StuartsProjects/HAB2/Pictures/Tracker HAB2 Parts.jpg

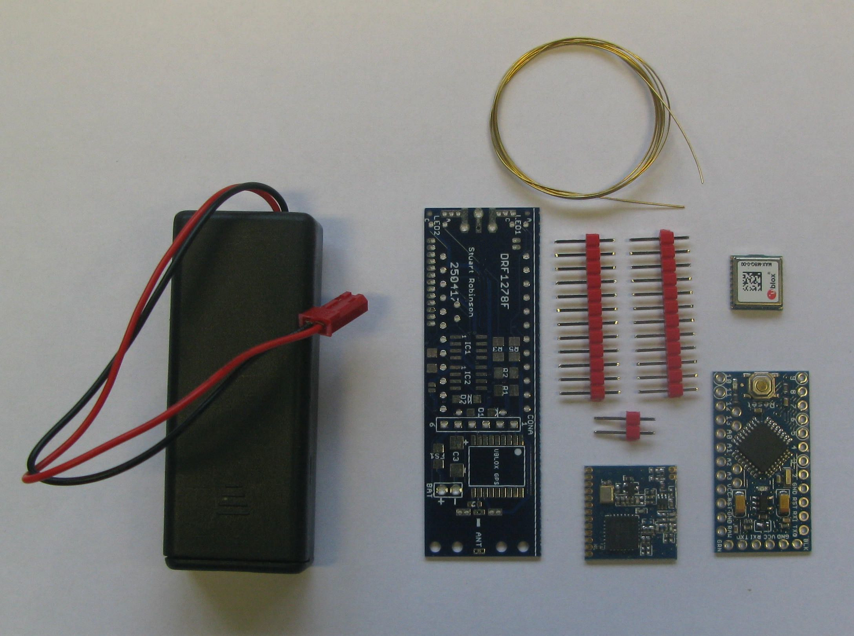
Pictures/Tracker HAB2 Parts.jpg
