StuartsProjects/HAB2/Pictures/Normal Pips.jpg

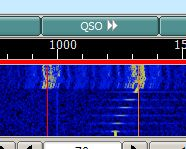
Pictures/Normal Pips.jpg
