StuartsProjects/HAB2/Board/GPS Breakout 200917 PCB.pdf

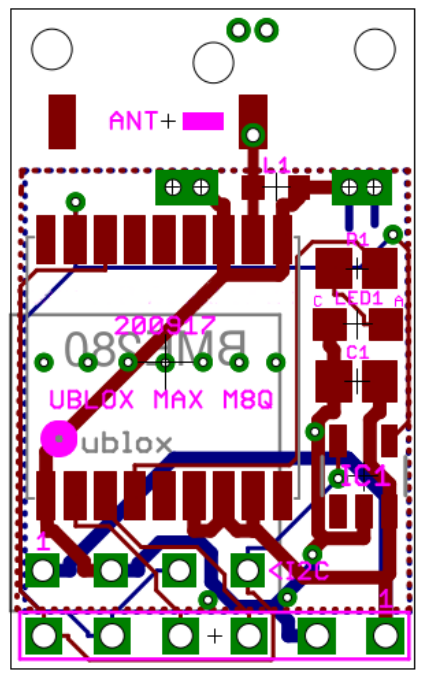
[picture p3: page 1]
