StuartsProjects/HAB2/Board/HAB2 Tracker RFM9x PCB 090218.pdf

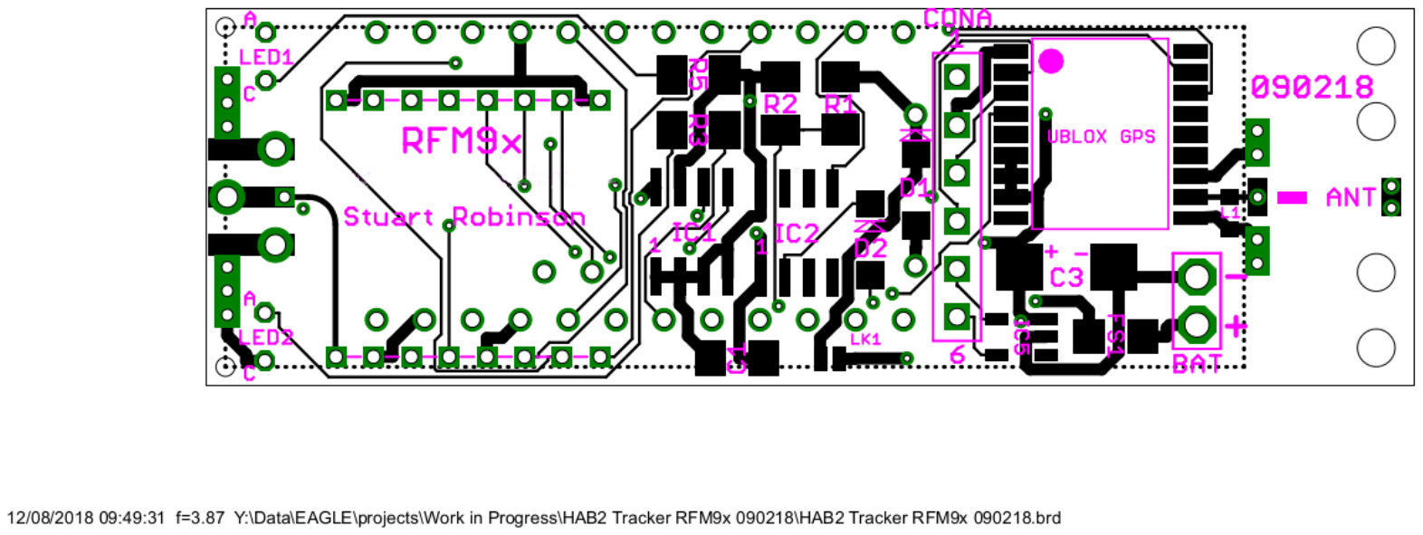
[picture p4: page 1]
