StuartsProjects/HAB2/Pictures/Breakout and BMP280.JPG

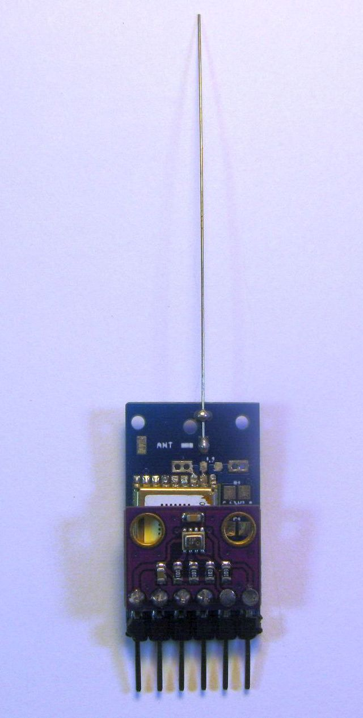
Pictures/Breakout and BMP280.JPG
