StuartsProjects/HAB2/Pictures/Breakout and TC74.JPG

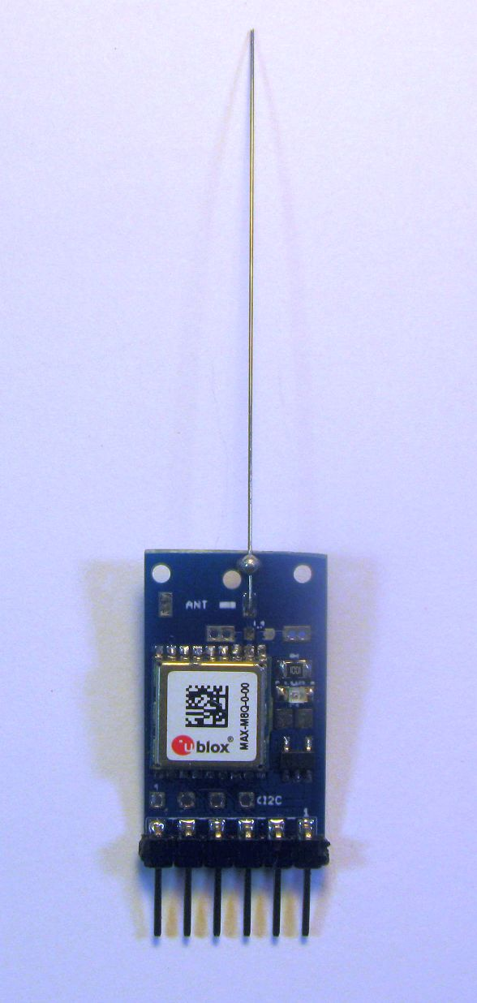
Pictures/Breakout and TC74.JPG
