StuartsProjects/HAB2/Pictures/GPS Breakout 200917.jpg

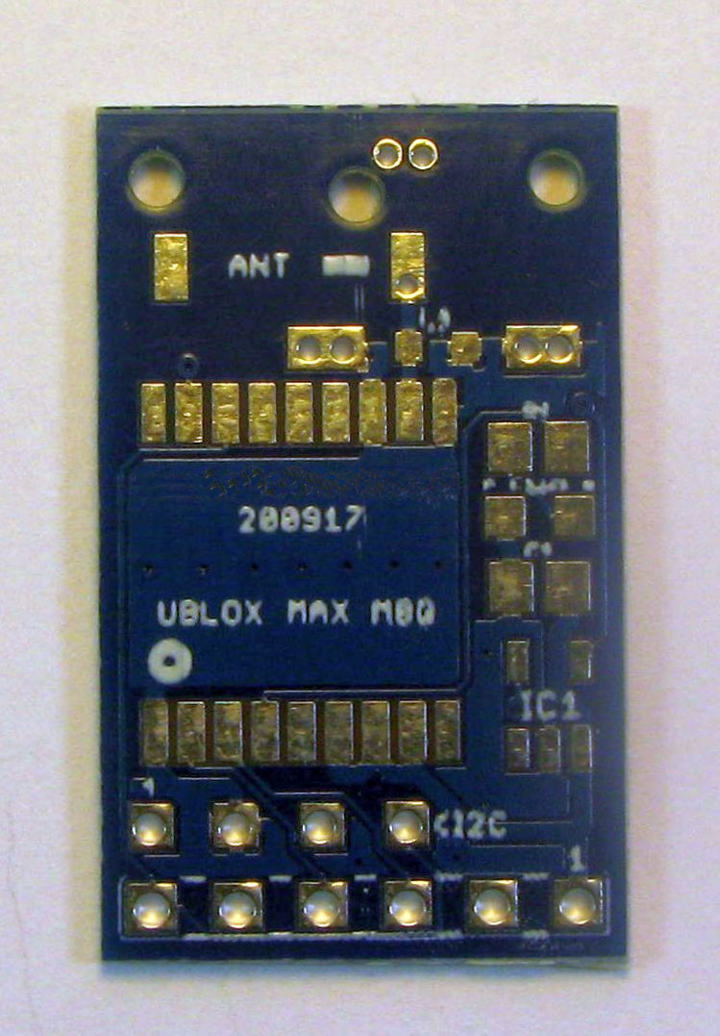
Pictures/GPS Breakout 200917.jpg
