StuartsProjects/HAB2/Pictures/HAB2 PCB.jpg

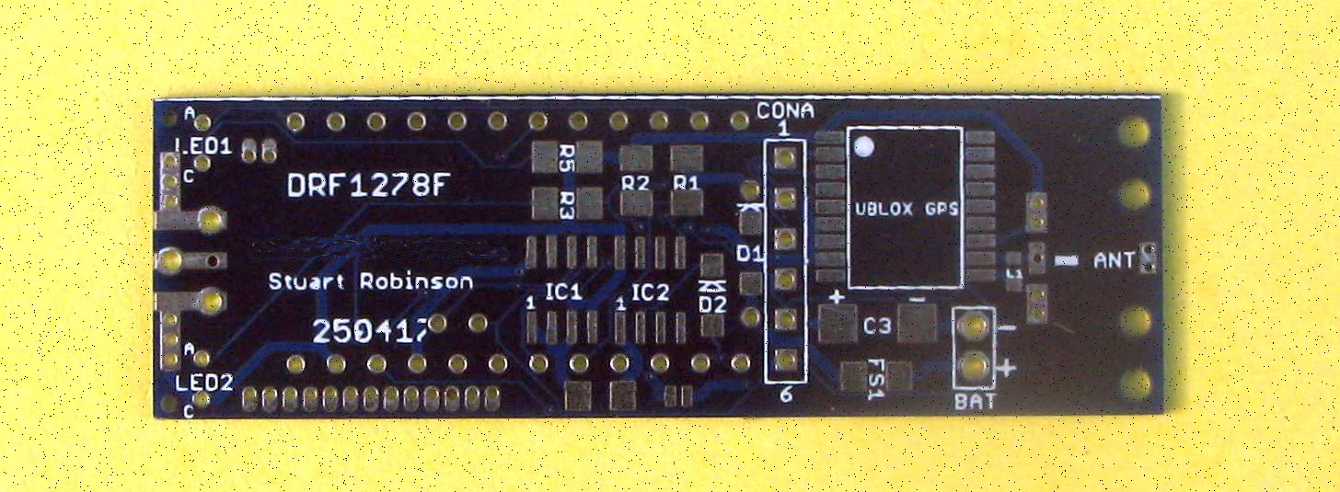
Pictures/HAB2 PCB.jpg
