StuartsProjects/HAB2/Pictures/IMG_1916.JPG

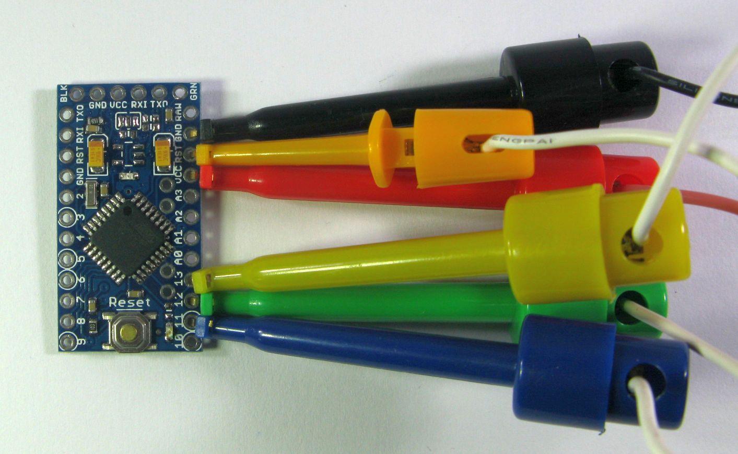
Pictures/IMG_1916.JPG
