StuartsProjects/HAB2/Pictures/IMG_1920.JPG

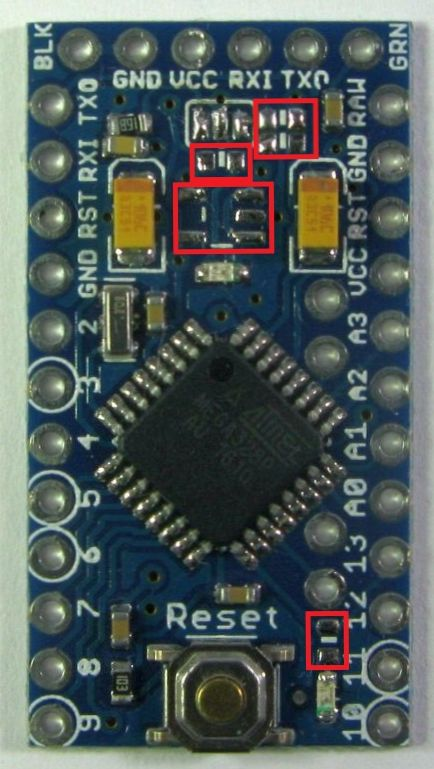
Pictures/IMG_1920.JPG
