StuartsProjects/HAB2/Pictures/IMG_1922.JPG

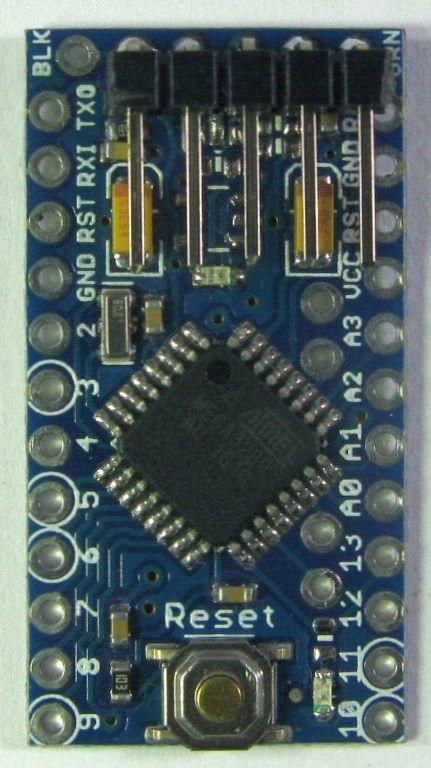
Pictures/IMG_1922.JPG
