StuartsProjects/HAB2/Pictures/IMG_1924.JPG

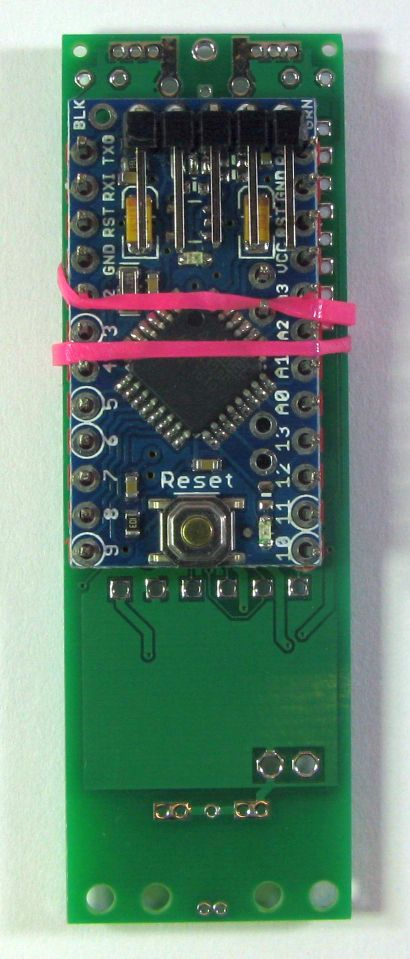
Pictures/IMG_1924.JPG
