StuartsProjects/HAB2/Pictures/IMG_1926.JPG

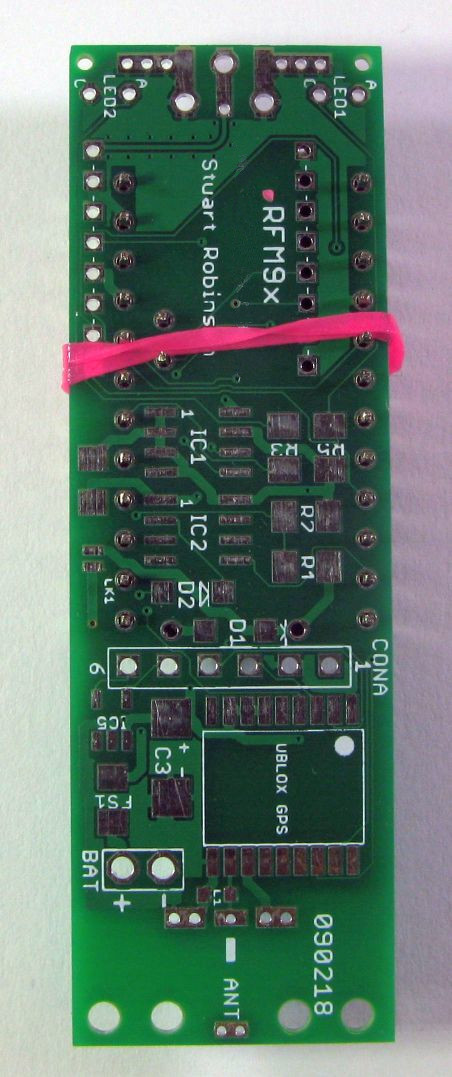
Pictures/IMG_1926.JPG
