StuartsProjects/HAB2/Pictures/IMG_1928.JPG

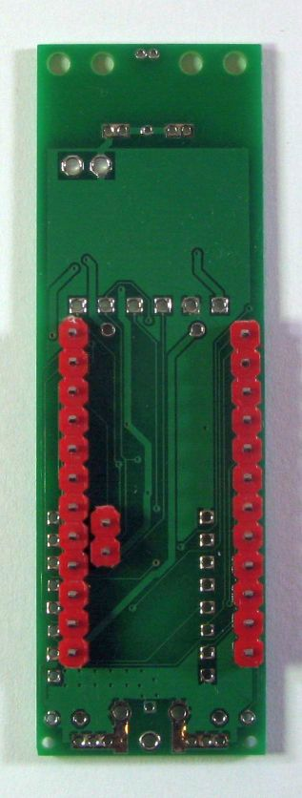
Pictures/IMG_1928.JPG
