StuartsProjects/HAB2/Pictures/IMG_1930.JPG

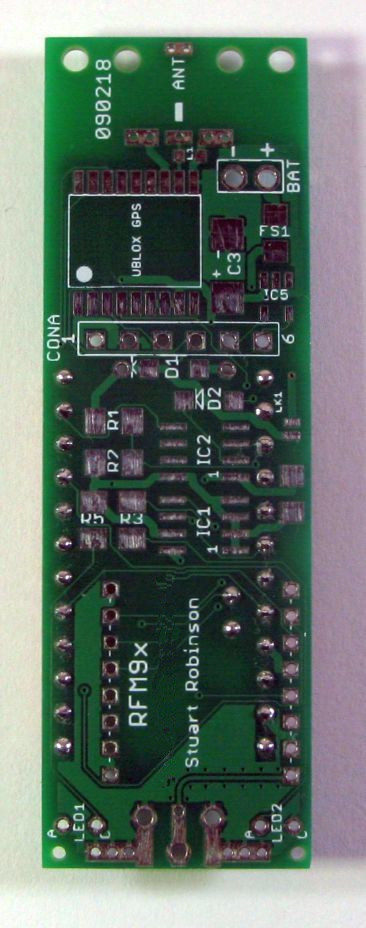
Pictures/IMG_1930.JPG
