StuartsProjects/HAB2/Pictures/IMG_1932.JPG

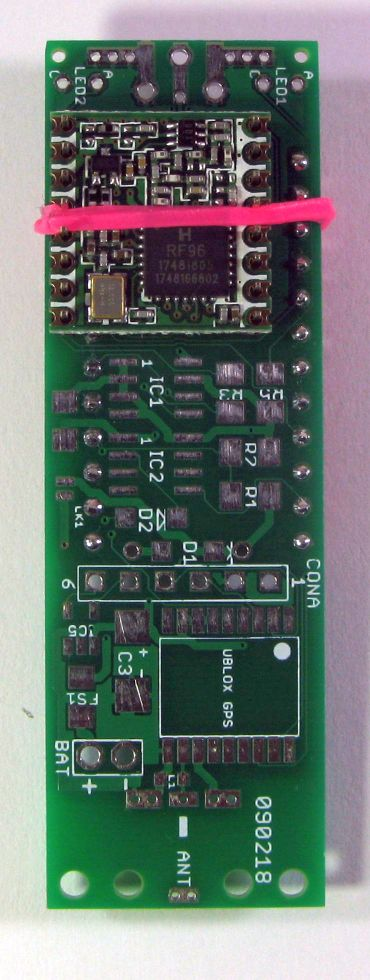
Pictures/IMG_1932.JPG
