StuartsProjects/HAB2/Pictures/IMG_1935.JPG

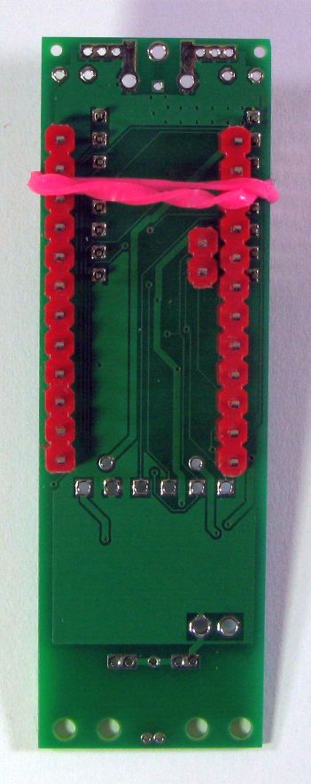
Pictures/IMG_1935.JPG
