StuartsProjects/HAB2/Pictures/IMG_1940.JPG

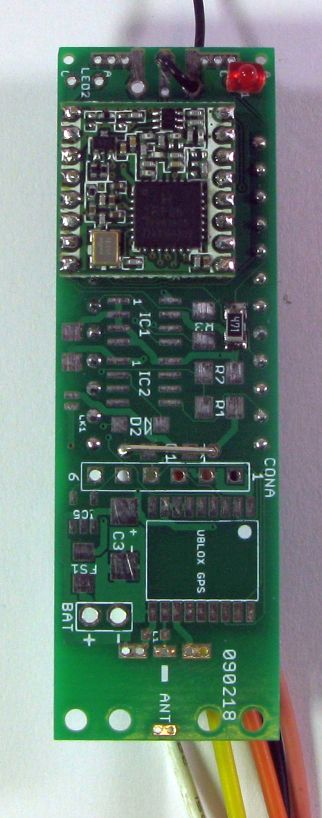
Pictures/IMG_1940.JPG
