StuartsProjects/HAB2/Pictures/IMG_1943.JPG

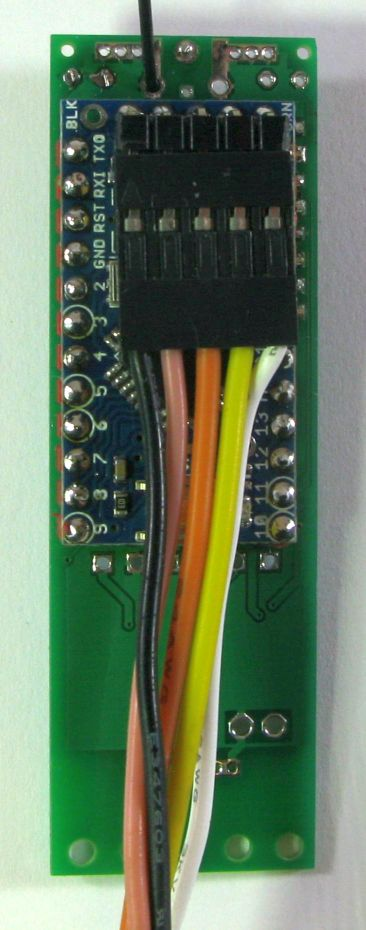
Pictures/IMG_1943.JPG
