StuartsProjects/HAB2/Pictures/IMG_1948.JPG

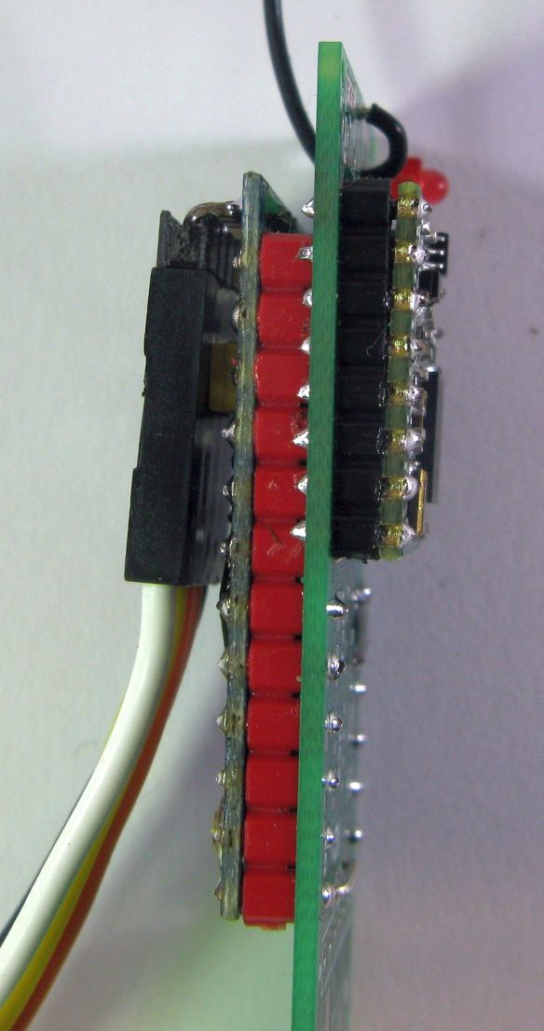
Pictures/IMG_1948.JPG
