StuartsProjects/HAB2/Pictures/IMG_1951.JPG

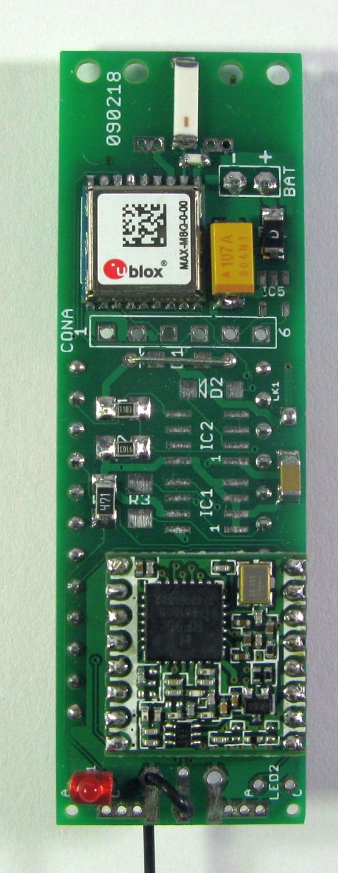
Pictures/IMG_1951.JPG
