StuartsProjects/HAB2/Pictures/IMG_1953.JPG

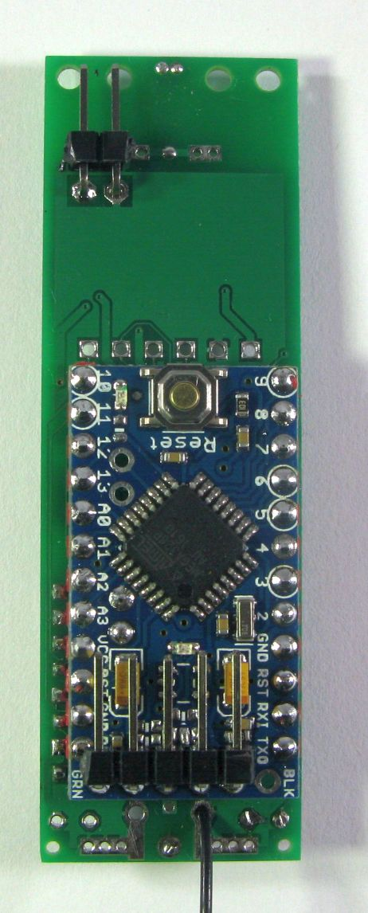
Pictures/IMG_1953.JPG
