StuartsProjects/HAB2/Pictures/Inverted Pips.jpg

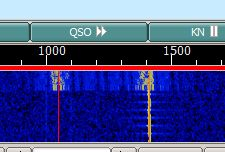
Pictures/Inverted Pips.jpg
