StuartsProjects/HAB2/Pictures/Tracker_HAB2.jpg

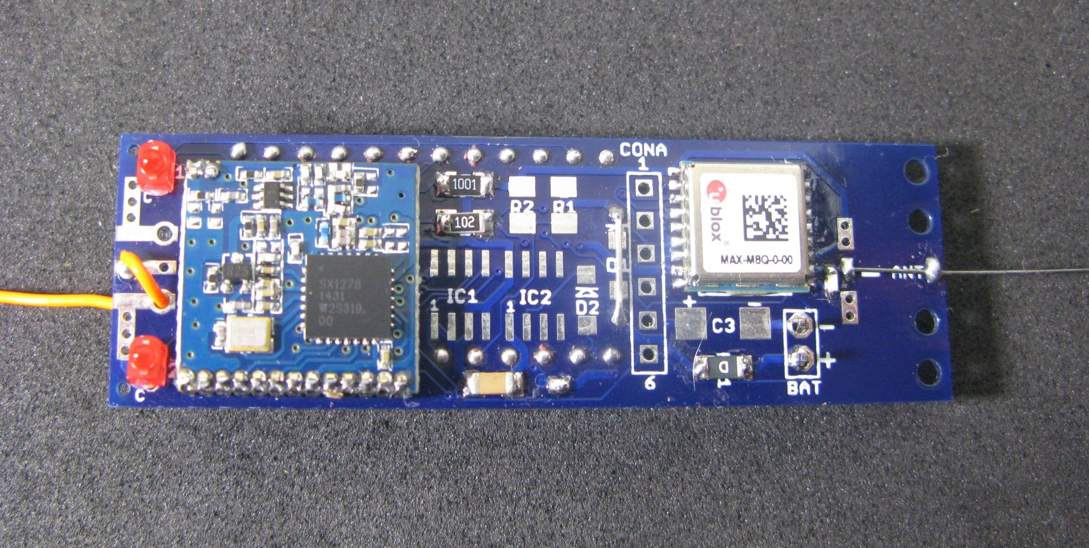
Pictures/Tracker_HAB2.jpg
