StuartsProjects/HAB2/Build/HAB2 Minimum Parts Tracker Build.pdf

HAB2 Minimum Parts Tracker Build

This describes the build of the HAB2 tracker board as a minimum component count high altitude balloon tracker which will be powered by 2 x AAA Energizer Lithium batteries. I will first list the components and what they are for, most can be omitted for this build.

PCB – This is needed, obviously, you can fit an SMA or U.FL socket for the antenna and also form a ¼ wave vertical with radials from guitar wire.

For such a minimum component count tracker powered with 2 x AAA Energizer Lithium batteries there is no need for the regulator on the Arduino Pro Mini as the voltage from the batteries will stay above 2.8V for most of their life, this is enough to run both the LoRa module and the Ublox GPS. These batteries are also rated to operate at -40C. To build such a tracker you only need to fit the components in red, put a wire link in place of D1 and a solder bridge on LK1. Follow the instructions ‘Modifying the Pro Mini for Low Power Operation’ to disconnect the LEDs and regulator on the Pro Mini. Fitting LED1 and R5 on the tracker board is not needed but is recommended, it makes testing the board during build easier.

ANT1 – Edge SMA, or just an angles SMA or guitar wire
ANT2 – Ceramic stick GPS antenna or better use guitar wire
BATCON – Where the battery goes, 2 pin 0.1” header or better solder direct wires C1 - Ceramic decoupler, recommended, 100nF OK, 4.7uF better
C2 - Omitted
C3 - Large value tantalum capacitor, can be omitted
D1A – Surface mount diode, reverse protection for battery, fit if not using 2 x AAAs D1B – Optional diode to D1A, fit wire link if using 2 x AAAs
D2 – For optional watchdog IC, can be omitted
FS1 – Fit this
IC1 – Optional I2C FRAM
IC2 – Optional Watchdog device
IC3 – The Arduino Pro Mini – this is needed!
IC4 – The LoRa device
L1 – Antistatic protection for GPS antenna input, recommended. LED1 - For indication only, can be omitted
LED2 - For GPS indication only can be omitted
R1 - Needed if reading battery voltage on RAW pin of Pro Mini R2 - Needed if reading battery voltage on RAW pin of Pro Mini R3 - For LED2
R5 - For LED1
UBLOX_MAX8Q – Needed

LoRa_Module_Test
V1.0
26/11/2017
Stuart Robinson

LED Flash

Checking LoRa Device

Registers after reset - LoRa Registers
Reg | 0 | 1 | 2 | 3 | 4 | 5 | 6 | 7 | 8 | 9 | A | B | C | D | E | F
0x00 | 00 00 00 00 00 00 00 00 00 00 00 00 00 00 00 00
0x10 | 00 00 00 00 00 00 00 00 00 00 00 00 00 00 00 00
0x20 | 00 00 00 00 00 00 00 00 00 00 00 00 00 00 00 00
0x30 | 00 00 00 00 00 00 00 00 00 00 00 00 00 00 00 00
0x40 | 00 00 00 00 00 00 00 00 00 00 00 00 00 00 00 00
0x50 | 00 00 00 00 00 00 00 00 00 00 00 00 00 00 00 00
0x60 | 00 00 00 00 00 00 00 00 00 00 00 00 00 00 00 00
0x70 | 00 00 00 00 00 00 00 00 00 00 00 00 00 00 00 00
Frequency 0.000MHz

Device Not Found

So we have checked that the Pro Mini can be programmed. Next we need to fit the Pro Mini in place and optionally add the LED (recommended). Be careful to fit the headers in the order indicated, if you do not you may not be able to solder the Pro Mini or LoRa module in place properly.

When you reconnect the programmer the program should now not have the rapid LED flashes, and the serial monitor output should show the register contents, see print out;

LoRa_Module_Test
V1.0
26/11/2017
Stuart Robinson

LED Flash

Checking LoRa Device

Registers after reset - LoRa Registers
Reg | 0 | 1 | 2 | 3 | 4 | 5 | 6 | 7 | 8 | 9 | A | B | C | D | E | F
0x00 | 00 09 1A 0B 00 52 6C 80 00 4F 09 2B 20 08 02 0A
0x10 | FF 70 15 0B 28 0C 12 47 32 3E 00 00 00 00 00 40
0x20 | 00 00 00 00 05 00 03 93 55 55 55 55 55 55 55 55
0x30 | 90 40 40 00 00 0F 00 00 00 F5 20 82 F2 02 80 40
0x40 | 00 00 12 24 2D 00 03 00 04 23 00 09 05 84 32 2B
0x50 | 14 00 00 11 00 00 00 0F E0 00 0C F2 07 00 5C 78
0x60 | 00 19 0C 4B CC 0E 7F 20 04 47 AF 3F 58 3F 90 0B
0x70 | D0 01 10 00 00 00 00 00 00 00 00 00 00 00 00 00
Frequency 434.000MHz

Device Present

Registers after setup - LoRa Registers
Reg | 0 | 1 | 2 | 3 | 4 | 5 | 6 | 7 | 8 | 9 | A | B | C | D | E | F
0x00 | D2 88 1A 0B 00 52 D9 00 00 4F 09 2B 23 01 80 00
0x10 | 00 00 00 00 00 00 00 00 10 00 00 00 00 78 77 64
0x20 | 00 08 01 FF 00 00 00 00 00 00 00 00 00 50 14 45
0x30 | 55 C3 05 27 1C 0A 03 0A 42 12 49 1D 00 AF 00 00
0x40 | 00 00 12 24 2D 00 03 00 04 23 00 09 05 84 32 2B
0x50 | 14 00 00 11 00 00 00 0F E0 00 0C 00 01 00 5C 78
0x60 | 00 19 0C 4B CC 00 01 20 04 47 AF 00 00 00 00 0B
0x70 | D0 01 11 00 00 00 00 00 00 00 00 00 00 00 00 00
Frequency 868.000MHz
Transmit FM Tone - Done

$Tracker1,1,10:10:10,51.48230,-3.18136,10,5,3999,-10,10,2,129,2000.0,5*9A96 TX Time 218mS

Note that it is normal for an 868Mhz module to have a set frequency of 434Mhz on power up or reset. Also note that the test program sends a test HAB packet;

$Tracker1,1,10:10:10,51.48230,-3.18136,10,5,3999,-10,10,2,129,2000.0,5*9A96

The fields are;

PayloadID,Sequence,Time,Lat,Lon,Alt,Sats,SupplyVolts,Temperature,Resets,Config0byte, StatusByte,Hertzoffset,GPSFixTime,Checksum

This program can therefore can be used to test a receiver, the location and LoRa parameters are defined at the start of the program listing.

The Ublox 8 GPS antenna input is sensitive to static damage so remember to take anti static precautions whilst soldering the GPS in position and any subsequent handling of the board. As an added precaution you can fit L1 which acts to connect DC wise the antenna input to ground. So solder the GPS in place, some ‘no clean’ flux put on the solder pads on the GPS as PCB will make the soldering easier. Fit the ceramic chip antenna or for a better performing antenna fit a 4.76cm length of guitar wire, I have used Ernie Ball Custom Gauge 9 to 13.

With the GPS and antenna in place load the test program; ‘EchoGPS_UBLOX_I2C_Test’

Using the GPS’s I2C interface this will turn off GLONASS mode, turn off GPGLL, GPGLS, GPGSA NMEA sentences, configure the GPS for high altitude use and check that the correct navigation mode is set. You should see the message ‘Dynamic Model is 6’ (this is needed for above 18000M operation) then start copying the output of the GPS to the serial monitor. Note that due to a recent change in the GPS library used there is no particular need to turn off GLONASS mode, but the command has been left in for compatibility reasons. Typical terminal monitor output;

EchoGPS_UBLOX_I2C_Test
V1.1
28/11/2017
Stuart Robinson
GPS GLONASS_Off B5 62 6 3E C 0 0 0 20 1 6 8 E 0 0 0 1 1 8F B2 Ack B5 62 05 01 02 00 06 3E 4C 75
GPS GPGLL_Off B5 62 6 1 8 0 F0 1 0 0 0 0 0 0 0 2A
Ack B5 62 05 01 02 00 06 01 0F 38
GPS GPGLS_Off B5 62 6 1 8 0 F0 5 0 0 0 0 0 0 4 46 Ack B5 62 05 01 02 00 06 01 0F 38
GPS GPGSA_Off B5 62 6 1 8 0 F0 2 0 0 0 0 0 0 1 31
Ack B5 62 05 01 02 00 06 01 0F 38
GPS SetNavigation B5 62 6 24 24 0 FF FF 6 3 0 0 0 0 10 27 0 0 5 0 FA 0 FA 0 64 0 2C 1 0 0 0 0 0 0 0 0 0 0 0 0 0 0 16 DC
Ack B5 62 05 01 02 00 06 24 32 5B
GPS Save B5 62 6 9 D 0 0 0 0 0 FF FF 0 0 0 0 0 0 1 1B A9 0
Ack B5 62 05 01 02 00 06 09 17 40
GPS PollNavigation B5 62 6 24 0 0 2A 84
Ack B5 62 06 24 24 00 FF FF 06 03 00 00 00 00 10 27 00 00 05 00 FA 00 FA 00 64 00 2C 01 00 00 00 00 00 00 C8 00 00 00 00 00 00 00 DE 1C
Dynamic Model is 6
Starting GPS Read

µb$2[$GPTXT,01,01,02,ANTSTATUS=INIT*25 $GPRMC,,V,,,,,,,,,,N*53
$GPGGA,,,,,,0,00,99.99,,,,,,*48 $GPGSV,1,1,00*79
$GPTXT,01,01,02,ANTSTATUS=OK*3B $GPRMC,,V,,,,,,,,,,N*53
$GPGGA,,,,,,0,00,99.99,,,,,,*48 $GPGSV,1,1,00*79
$GPRMC,,V,,,,,,,,,,N*53
$GPGGA,,,,,,0,00,99.99,,,,,,*48 $GPGSV,1,1,00*79

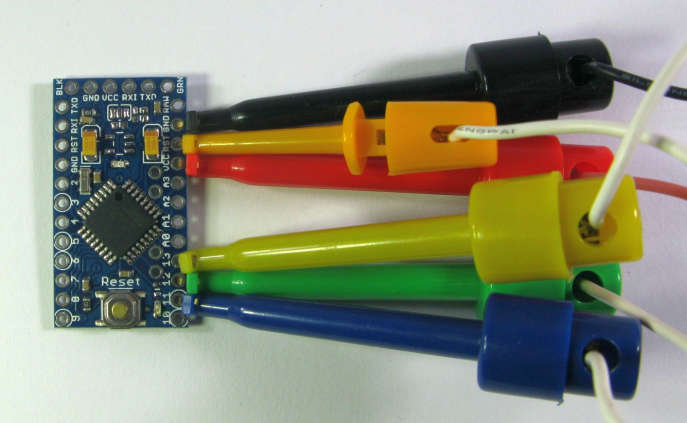
[picture p25: figure]

Stuart Robinson
August 2018
