StuartsProjects/HAB2/Parts/HAB2.xls

Part | Value | Package | Description
ANT1 | SMA | CUSTOMSMA | SMA socket or wire
ANT2 | JTI_ANTENNA-1575AT43A40 | JTI_ANTENNA-1575AT43A40 | Ceramic stick or wire
BATCON | BATCON | BATCON | 2 pin connector
C1 | 100nF | C-EUC1206 | Ceramic
C3 | 220uF | CPOL-EUSMCC | Optional Tantalum
D1A | B0520 | DIODE-SOD123 | DIODE Fit A or B
D1B | BAT51 | PIHDIODE | DIODE Fit A or B
D2 | B0520 | DIODE-SOD123 | DIODE
FS1 | 250mA | R-EU_R1206 | RESISTOR, European symbol
IC1 | MB85RC16PNF (207-0257) | 24L256 | I2C FRAM
IC2 | Watchdog1 | 12F1840_SOIC | Optional Watchdog device
IC3 | ARDUONOPROMINI | ARDUONOPROMINI_NOHEADER2 | Must be 3.3V version
IC4 | DRF1278F | DRF1278F | LoRa Device
L1 | 33nH | R-EU_R0603 | RESISTOR, European symbol
LED1 | 2PIN | 1.8MM
LED2 | 2PIN | 1.8MM
R1 | 91K | R-EU_M1206 | RESISTOR, European symbol
R2 | 11K | R-EU_M1206 | RESISTOR, European symbol
R3 | 1K | R-EU_M1206 | RESISTOR, European symbol
R5 | 1K | R-EU_M1206 | RESISTOR, European symbol
UBLOX_MAX8Q | UBLOX_MAX | UBLOX_MAX | UBLOX MAX
