StuartsProjects/HAB2/Schematic/GPS Breakout 200917 Schematic.pdf

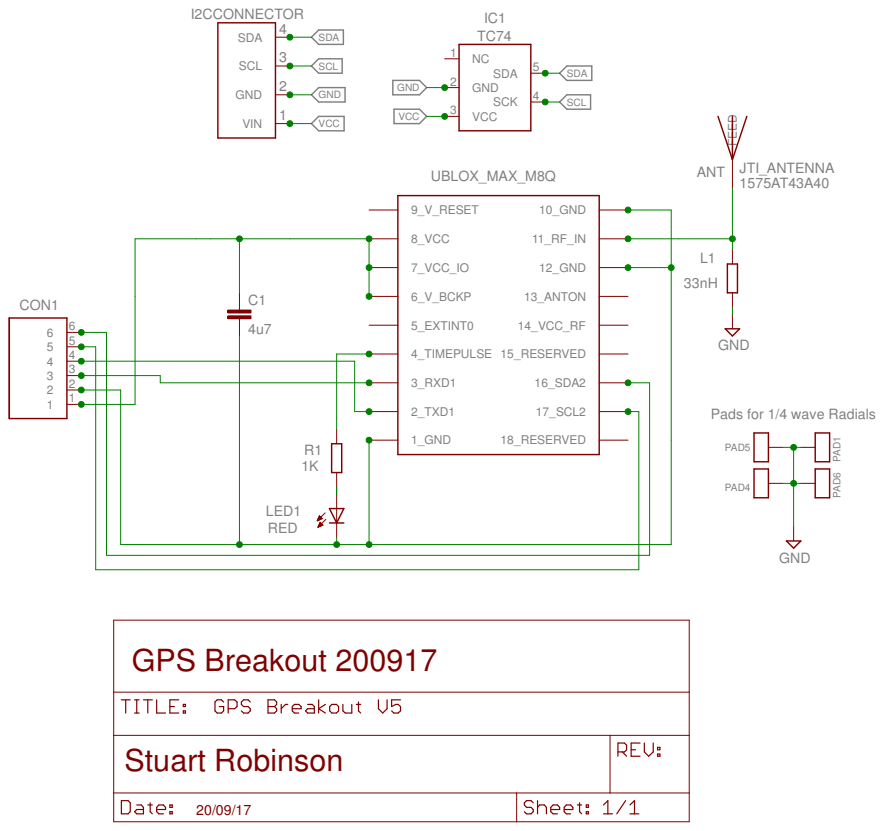
[picture p28: page 1]
JTI_ANTENNA 1575AT43A40; RED; GND; 10_GND; 12_GND; 13_ANTON; 14_VCC_RF; 15_RESERVED; 16_SDA2; 17_SCL2; 18_RESERVED; 9_V_RESET; 8_VCC; 7_VCC_IO; 6_V_BCKP; 5_EXTINT0; 4_TIMEPULSE; 3_RXD1; 2_TXD1; 1_GND; UBLOX_MAX_M8Q; LED1; FEED; ANT; PAD4; PAD6; PAD5; PAD1; CON1; GND 2; VCC 3; SCK; SDA; SCL; VIN; I2CCONNECTOR; VCC VCC; GND GND; GPS Breakout 200917; Stuart Robinson

Pads for 1/4 wave Radials
