StuartsProjects/HAB2/Schematic/HAB2 Tracker DRF1278F 070618 Schematic.pdf

# ARDUONOPROMINI_NOHEADER2

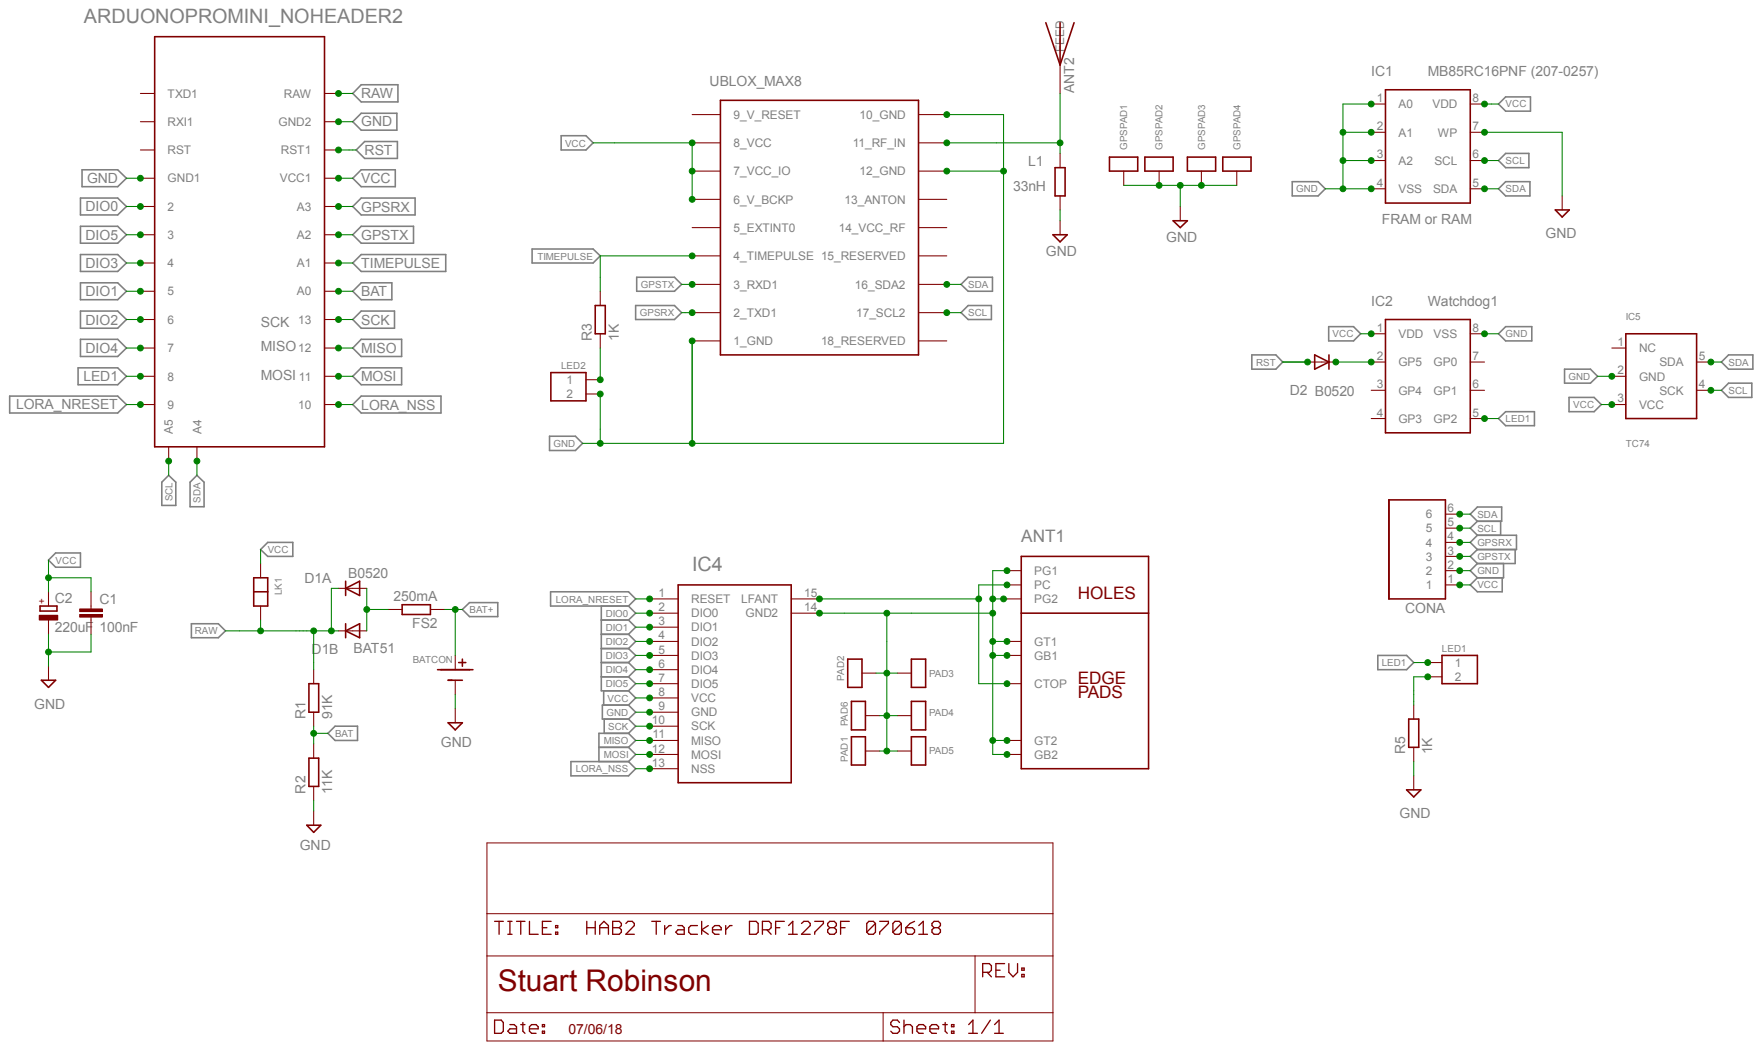
[picture p29: page 1]
