StuartsProjects/HAB2/Schematic/HAB2 Tracker RFM9x 090218 Schematic.pdf

# ARDUONOPROMINI_NOHEADER2

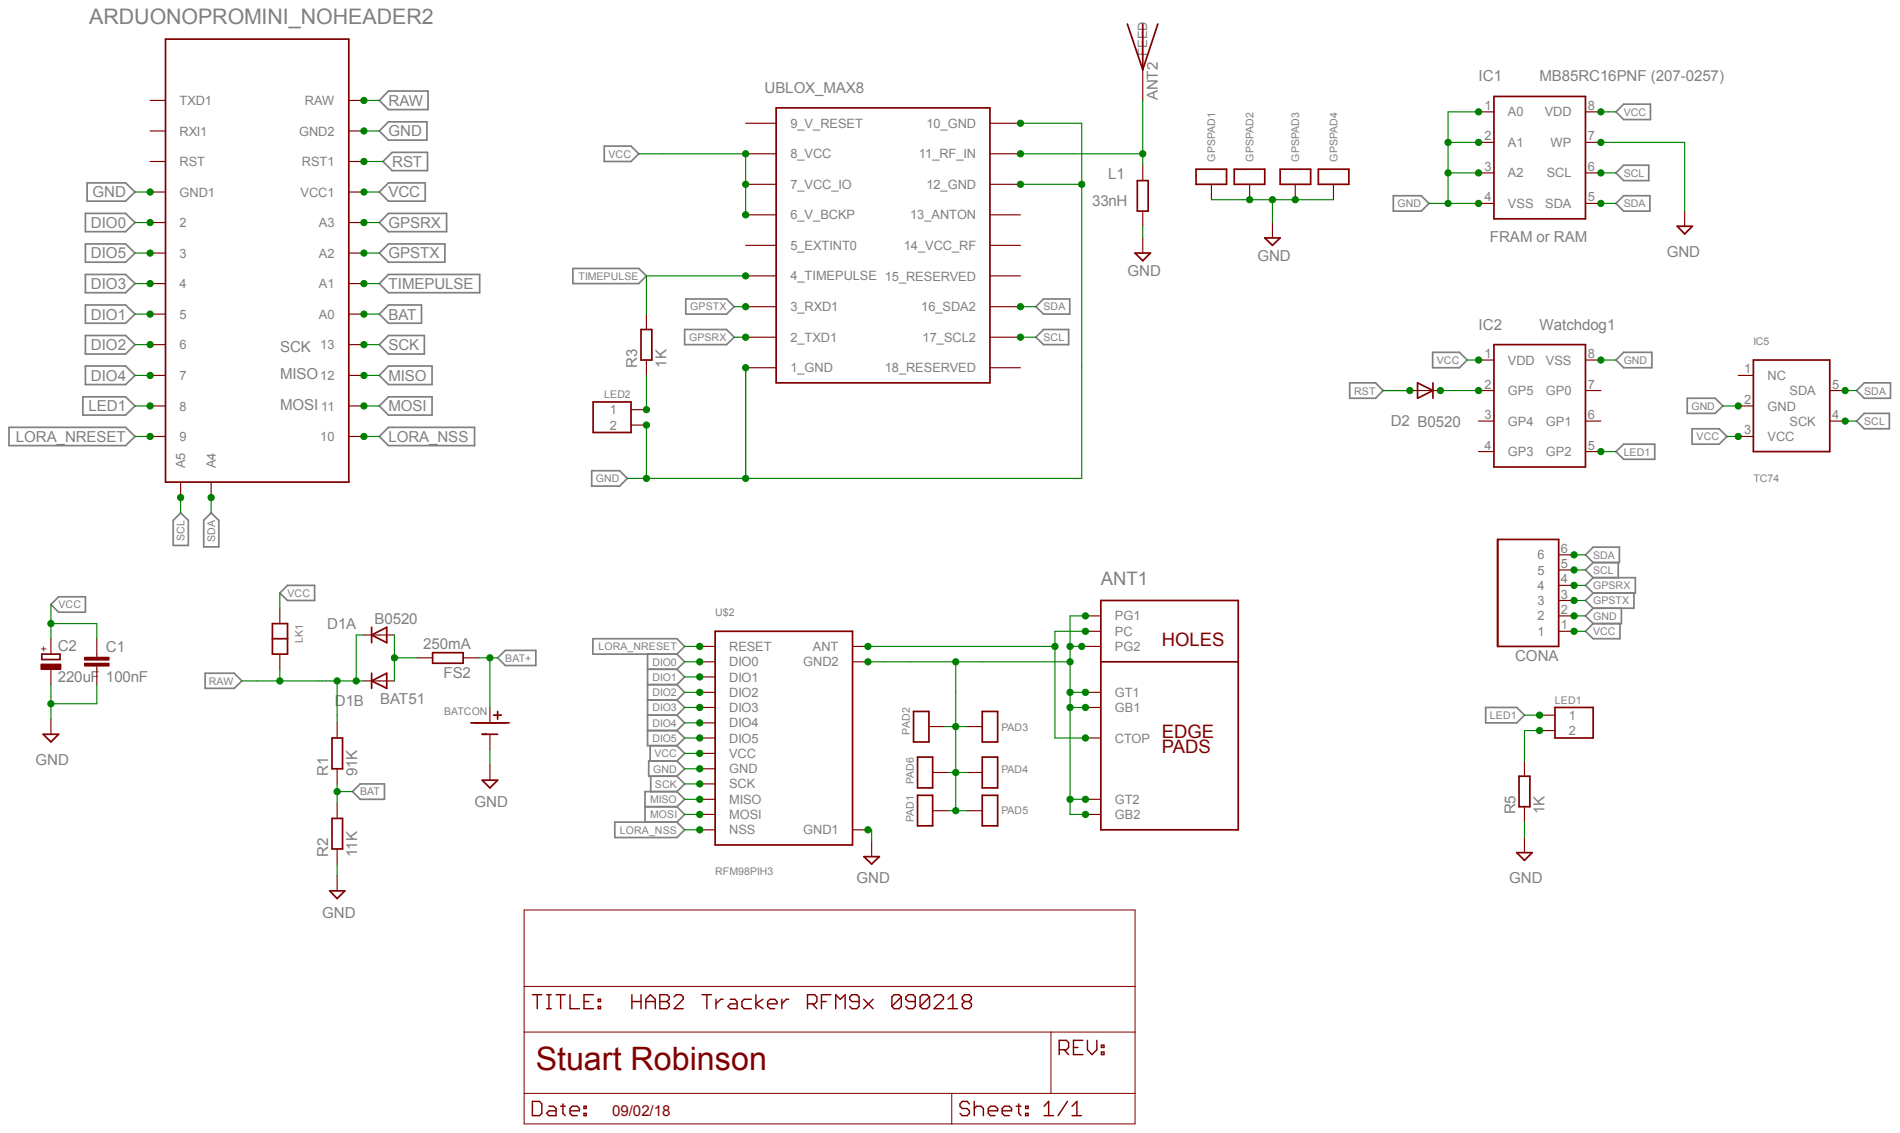
[picture p30: page 1]
