StuartsProjects/HAB2/(commit log)

2017-08-15 Removed unused files, up dated currents used
2017-10-03 Updated assembly instructions
    [HAB2.xls]
2017-10-11 111017 - Changes to Readme notes, removed unneeded board definitions
2017-11-14 Added note about where to find list of components required to build tracker.
    [HAB2.xls]
2017-11-24 Added information on GPS Breakout board
2018-01-27 Corrections to remove some compiler warnings
    [LoRaTracker_HAB2_101017.ino, LoRaTracker_HAB2_Settings.h, TC74_Temperature_Sensor_Test.ino]
2019-03-29 Correct image corruption in build instructions
    [LoRaTracker_HAB2_101017.ino, LoRaTracker_HAB2_Bare_Bones_200518.ino, LoRaTracker_HAB2_Settings.h]
